Kaylam60/SLAM-Based-Robot/README.md

This contains all the labs I did for ECE 4160: Fast Robots, as well as my implementations for Cornell Robotics Day.
