Kaylam60/SLAM-Based-Robot/assets/lab1/ex_2analogread.png

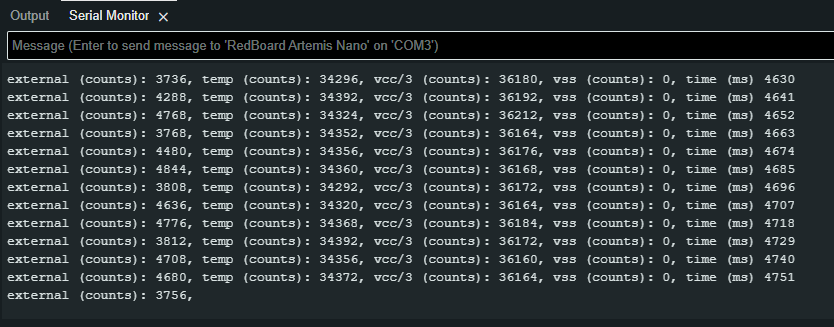
assets/lab1/ex_2analogread.png
