Kaylam60/SLAM-Based-Robot/assets/lab5/Screenshot 2024-03-16 004336.png

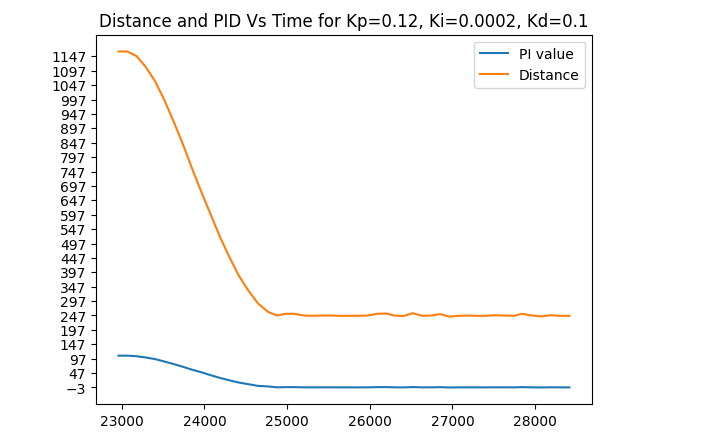
assets/lab5/Screenshot 2024-03-16 004336.png
